panjanek/attiny85logbook/(commit log)

2024-08-11 arduino code
2024-08-11 schematics as PNG
2024-08-11 pcb layout
